charliemillhollinUST/TeensyDAQ_Hardware/README.md

The schematic and PCB were created in KiCad.

Contact <mill70882@stthomas.edu> for access to the TeensyDAQ repository.

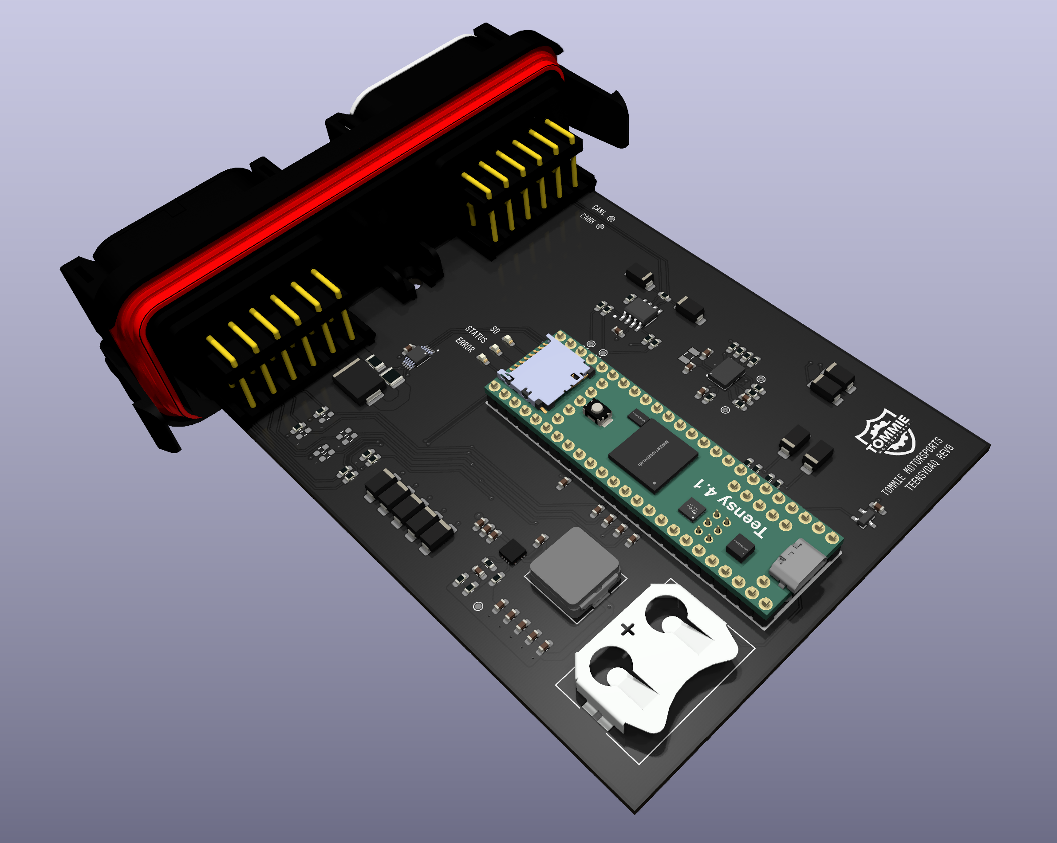
[picture p1: images/board_projection.png]
PCB
