charliemillhollinUST/TeensyDAQ_Hardware/images/board_bottom.png

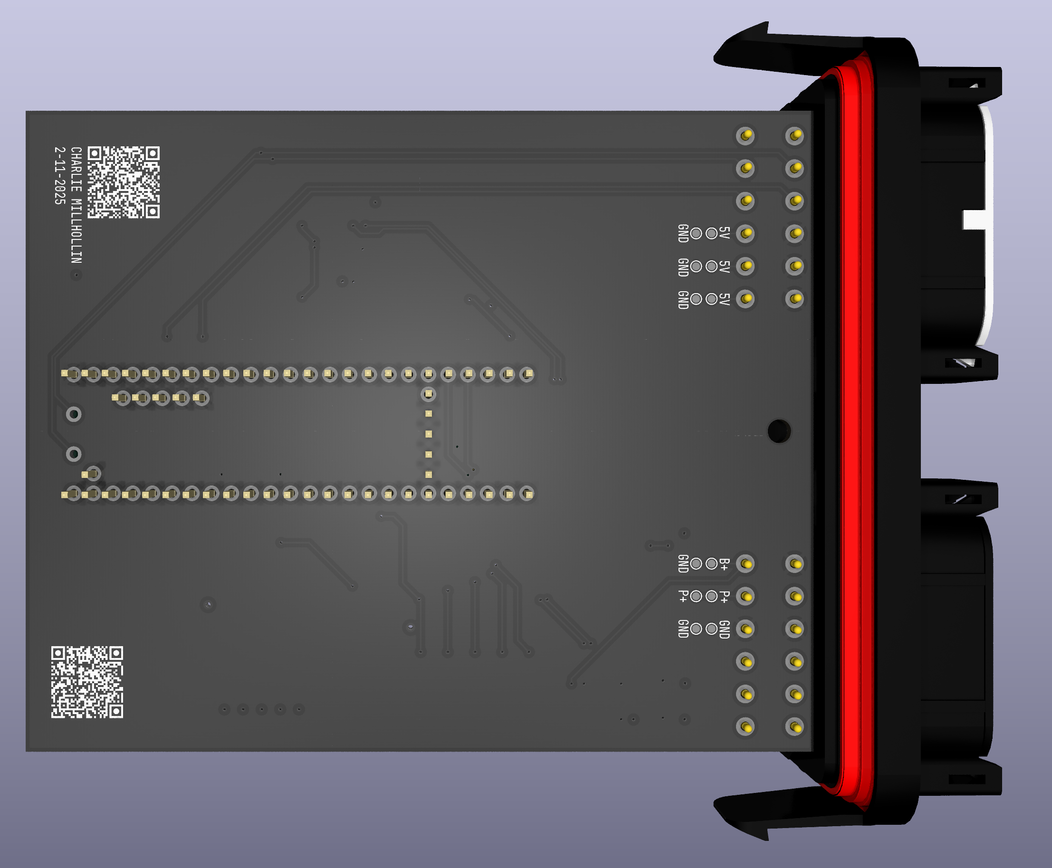
images/board_bottom.png
