charliemillhollinUST/TeensyDAQ_Hardware/images/board_top.png

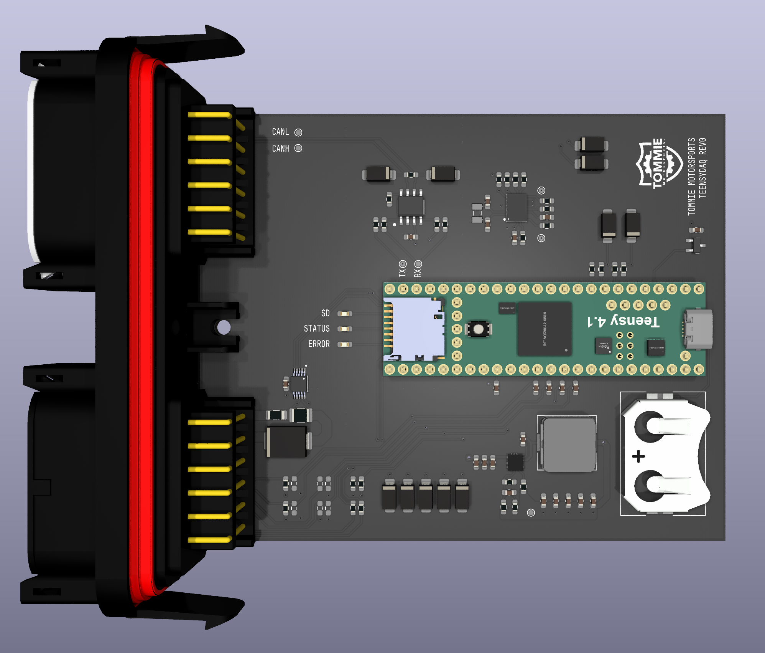
images/board_top.png
