charliemillhollinUST/TeensyDAQ_Hardware/TeensyDAQ_REV0.kicad_pcb

## KiCad design TeensyDAQ_REV0.kicad_pcb (2025-02-15)

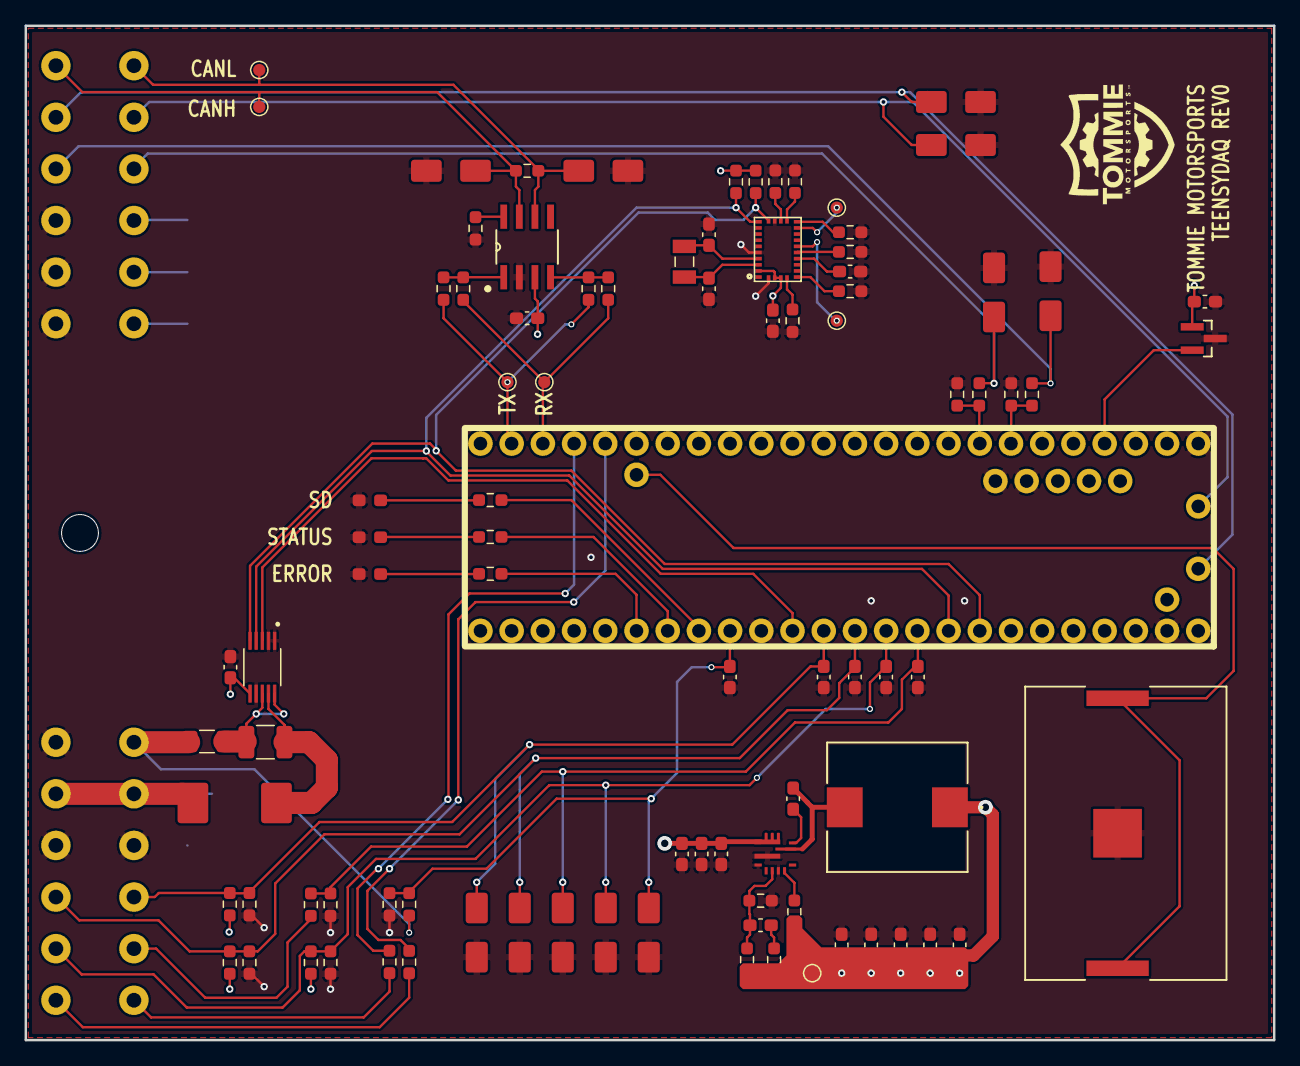
[picture p4: board TeensyDAQ_REV0.kicad_pcb from above]

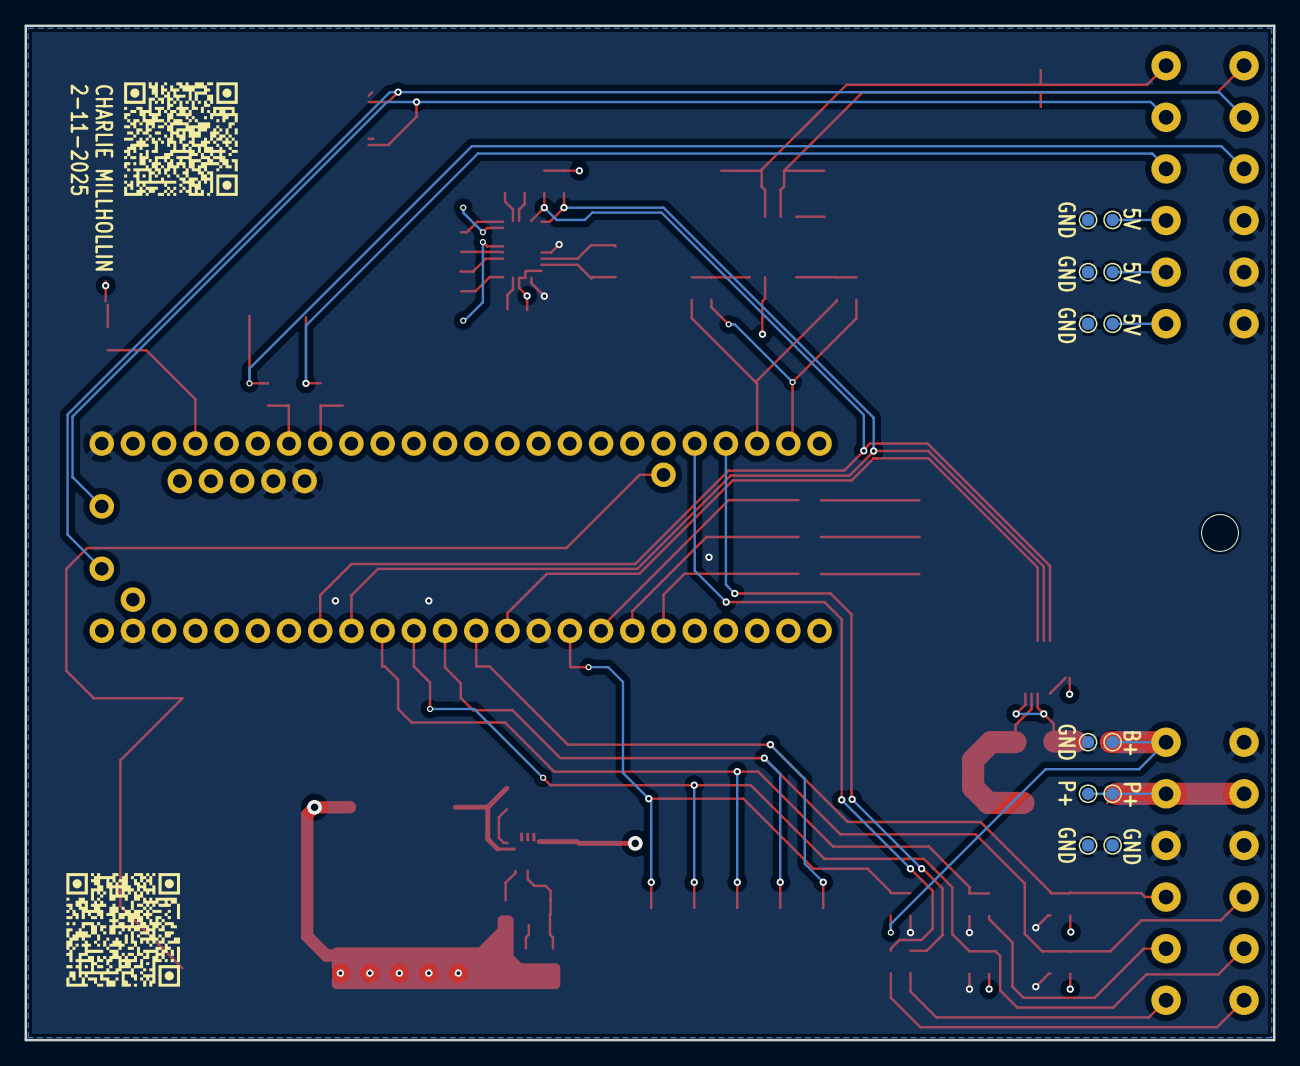
[picture p5: board TeensyDAQ_REV0.kicad_pcb from below]

Board: 4 copper layers, 101.6 x 82.6 mm, 105 parts (12 on the bottom side), 57 nets.

Parts:
5V, 5V103, 5V#2, 5V#3: TestPoint; TestPoint_Pad_D1.0mm
B100: 3034; 3034_KEY
B+: TestPoint; TestPoint_Pad_D1.0mm
C100, C101, C105, C106, C107, C108, C109: 10u; C_0603_1608Metric_Pad1.08x0.95mm_HandSolder
C102, C116, C117: 100n; C_0603_1608Metric_Pad1.08x0.95mm_HandSolder
C103, C110, C111, C112, C113, C114, C115, C120, C121: 0.1u; C_0603_1608Metric_Pad1.08x0.95mm_HandSolder
C104: 100p; C_0603_1608Metric_Pad1.08x0.95mm_HandSolder
C118, C119: 22p; C_0603_1608Metric_Pad1.08x0.95mm_HandSolder
CANH: TestPoint; TestPoint_Pad_D1.0mm
CANL: TestPoint; TestPoint_Pad_D1.0mm
D100, D101, D102: LED; LED_0603_1608Metric_Pad1.05x0.95mm_HandSolder
D103: B340; D_SMC
D104, D105, D106, D107, D108, D109, D110, D111, D112, D113, D115: SMAJ5.0A; D_SMA
F100: Fuse; Fuse_1206_3216Metric
GND: TestPoint; TestPoint_Pad_D1.0mm
GND#2, GND#3, GND#4, GND#5, GND#6: TestPoint; TestPoint_Pad_D1.0mm
J100: ATM13-12PA-12PB-BM01
L100: 3.3u; IND_IHLP-4040DZ_VIS
P+: TestPoint; TestPoint_Pad_D1.0mm
P+#2: TestPoint; TestPoint_Pad_D1.0mm
Q100: Teensy4_1
R100, R101, R102: 10; R_0603_1608Metric_Pad0.98x0.95mm_HandSolder
R103, R119, R121: 100k; R_0603_1608Metric_Pad0.98x0.95mm_HandSolder
R104: 20k; R_0603_1608Metric_Pad0.98x0.95mm_HandSolder
R105: 73.2k; R_0603_1608Metric_Pad0.98x0.95mm_HandSolder
R106, R113, R115, R117, R128, R129, R133, R134, R135: 10k; R_0603_1608Metric_Pad0.98x0.95mm_HandSolder
R107, R108, R109, R110, R111, R130, R131, R132, R140, R141: 0; R_0603_1608Metric_Pad0.98x0.95mm_HandSolder
R112: 120; R_0603_1608Metric_Pad0.98x0.95mm_HandSolder
R114, R116: 15k; R_0603_1608Metric_Pad0.98x0.95mm_HandSolder
R118: 3k; R_0603_1608Metric_Pad0.98x0.95mm_HandSolder
R120, R122, R123, R124, R125, R126: DNP; R_0603_1608Metric_Pad0.98x0.95mm_HandSolder
R127: 0.1; R_1210_3225Metric_Pad1.30x2.65mm_HandSolder
RX: TestPoint; TestPoint_Pad_D1.0mm
TP100, TP101: TestPoint; TestPoint_Pad_D1.0mm
TX: TestPoint; TestPoint_Pad_D1.0mm
U100: TPS56637RPAR; RPA0010A
U101: INA226AIDGSR
U102: BNO055; LGA28R50P4X10_380X520X100
U103: SN65HVD230DR; D8
U104: DRV5032FBDBZR; DBZ0003A-IPC_A
Y100: ABS07-32.768KHZ-T; XTAL_ABS07-32.768KHZ-T

Connections:
+3V3: C114.1, C116.2, C120.1, C121.1, Q100.-2 (3.3V), Q100.-5 (3.3V), R119.2, R121.2, R125.2, R128.2, R129.2, U101.6 (VS), U102.3 (VDD), U102.4 (NBOOT_LOAD_PIN), U102.28 (VDDIO), U103.3 (VCC), U104.1 (VCC)
+5V: 5V.1, 5V103.1, 5V#2.1, 5V#3.1, C105.2, C106.2, C107.2, C108.2, C109.2, J100.10 (Pin_10_1), J100.11 (Pin_11_1), J100.12 (Pin_12_1), L100.1, Q100.-3 (Vin), R103.2, R104.2, R105.2
/Analog/Battery_IN+: B+.1, F100.1, J100.13 (Pin_1_2), R117.2
/Analog/CVT_Thermistor+: C111.1, D110.1 (A1), J100.21 (Pin_9_2), Q100.15, R121.1, R122.2
/Analog/Engine_Thermistor+: C110.1, D113.1 (A1), J100.16 (Pin_4_2), Q100.14, R119.1, R120.2
/Analog/Hall_Signal1: D109.1 (A1), J100.4 (Pin_4_1), R113.2
/Analog/Hall_Signal1_u: Q100.5, R113.1, R114.2
/Analog/Hall_Signal2: D104.1 (A1), J100.9 (Pin_9_1), R115.2
/Analog/Hall_Signal2_u: Q100.6, R115.1, R116.2
/Analog/Magnet_u: Q100.2, U104.2 (OUT)
/Analog/Thermistor3_u: C113.1, D111.1 (A1), J100.20 (Pin_8_2), Q100.16, R125.1, R126.2
/Analog/VDIV1+: J100.17 (Pin_5_2), R123.2
/Analog/VDIV1_u: C112.1, D112.1 (A1), Q100.17, R123.1, R124.2
/Analog/VMeas_BATu: C115.1, D115.1 (A1), Q100.41, R117.1, R118.2
/CAN/CANH: CANH.1, D107.1 (A1), J100.6 (Pin_6_1), R112.2, U103.7 (CANH)
/CAN/CANL: CANL.1, D106.1 (A1), J100.7 (Pin_7_1), R112.1, U103.6 (CANL)
/CAN/CAN_RXu: Q100.30, R107.2, R108.2, RX.1
/CAN/CAN_TXu: Q100.31, R109.2, R110.2, TX.1
/Enclosure Connectors/P1: J100.18 (Pin_6_2), R141.1
/Enclosure Connectors/P2: J100.19 (Pin_7_2), R140.1
/Enclosure Connectors/Power_OUT+: C100.2, C101.2, C102.2, D103.1 (K), J100.14 (Pin_2_2), J100.23 (Pin_11_2), P+.1, P+#2.1, U100.8 (VIN)
/Enclosure Connectors/USB_D+: D105.1 (A1), J100.8 (Pin_8_1), Q100.-9 (D+_Device)
/Enclosure Connectors/USB_D-: D108.1 (A1), J100.5 (Pin_5_1), Q100.-8 (D-_Device)
/Gyro/I2C_SCL: Q100.19, R129.1, U101.5 (SCL), U102.19 (COM1)
/Gyro/I2C_SDA: Q100.18, R128.1, U101.4 (SDA), U102.20 (COM0)
/Power Biasing/INA226A_ALERT: Q100.13, U101.3 (ALERT)
CUR_S_+: F100.2, R127.1, U101.8 (VBUS), U101.10 (IN+)
CUR_S_-: D103.2 (A), R127.2, U101.9 (IN-)
ERROR_LED: Q100.38, R102.1
GND: B100.3, C100.1, C101.1, C102.1, C105.1, C106.1, C107.1, C108.1, C109.1, C110.2, C111.2, C112.2, C113.2, C114.2, C115.2, C116.1, C117.2, C118.2, C119.1, C120.2, C121.2, D100.1 (K), D101.1 (K), D102.1 (K), D104.2 (A2), D105.2 (A2), D106.2 (A2), D107.2 (A2), D108.2 (A2), D109.2 (A2), D110.2 (A2), D111.2 (A2), D112.2 (A2), D113.2 (A2), D115.2 (A2), GND.1, GND#2.1, GND#3.1, GND#4.1, GND#5.1, GND#6.1, J100.1 (Pin_1_1), J100.2 (Pin_2_1), J100.3 (Pin_3_1), J100.15 (Pin_3_2), J100.22 (Pin_10_2), J100.24 (Pin_12_2), Q100.-1 (GND), Q100.-4 (GND), Q100.-6 (GND), Q100.-13 (GND), Q100.-14 (GND), R106.1, R111.2, R114.1, R116.1, R118.1, R120.1, R122.1, R124.1, R126.1, R130.2, R131.2, R132.2, R133.2, R134.2, R135.2, U100.3 (AGND), U100.9 (PGND), U100.10 (MODE), U101.1 (A1), U101.2 (A0), U101.7 (GND), U102.2 (GND), U102.18 (COM2), U102.25 (GNDIO), U103.2 (GND), U104.3 (GND)
unnamed: C104.2, R104.1
unnamed: D100.2 (A), R102.2
unnamed: D101.2 (A), R101.2
unnamed: D102.2 (A), R100.2
unnamed: Q100.28, R140.2
unnamed: Q100.29, R141.2
unnamed: C103.2, U100.7 (BOOT)
unnamed: C104.1, R105.1, R106.2, U100.2 (FB)
unnamed: R103.1, U100.4 (PG)
unnamed: C103.1, L100.2, U100.6 (SW)
unnamed: C117.1, U102.9 (CAP)
unnamed: R133.1, U102.17 (COM3)
unnamed: TP101.1, U102.14 (INT)
unnamed: TP100.1, U102.11 (NRESET)
unnamed: R130.1, U102.10 (PIN10)
unnamed: R131.1, U102.15 (PIN15)
unnamed: R132.1, U102.16 (PIN16)
unnamed: R134.1, U102.6 (PS0)
unnamed: R135.1, U102.5 (PS1)
unnamed: R107.1, R109.1, U103.1 (D)
unnamed: R108.1, R110.1, U103.4 (R)
unnamed: R111.1, U103.8 (RS)
RTC_BAT+: B100.1, B100.2, Q100.-19 (VBAT)
SD_LED: Q100.40, R101.1
XIN32: C118.1, U102.27 (XIN32), Y100.1
XOUT32: C119.2, U102.26 (XOUT32), Y100.2
uLED: Q100.39, R100.1
