charliemillhollinUST/TeensyDAQ_Hardware/(commit log)

2025-01-23 cleaned up routing on main page of schematic
    [TeensyDAQ_REV0.kicad_sch]
2025-01-25 test commit
    [Teensy.kicad_sch]
2025-02-11 Added gyro, current sense, removed servo control, added temp sense
    [ATM13-12PA-12PB-BM01.kicad_sch, Analog.kicad_sch, CAN.kicad_sch, Power_Biasing.kicad_sch, Teensy.kicad_sch, TeensyDAQ_REV0.kicad_pcb, TeensyDAQ_REV0.kicad_sch, gyro.kicad_sch]
2025-02-11 finished up schematic, added magnetic sensor, cleaned up pins, etc.
    [ATM13-12PA-12PB-BM01.kicad_sch, Analog.kicad_sch, CAN.kicad_sch, Power_Biasing.kicad_sch, Teensy.kicad_sch, TeensyDAQ_REV0.kicad_pcb, TeensyDAQ_REV0.kicad_sch, gyro.kicad_sch]
2025-02-11 cleaned up refdes
    [CAN.kicad_sch, TeensyDAQ_REV0.kicad_pcb]
2025-02-11 final route. Needs revision and check of via placement.
    [ATM13-12PA-12PB-BM01.kicad_sch, Teensy.kicad_sch, TeensyDAQ_REV0.kicad_pcb]
2025-02-11 added ground planes and 4 layer. Ran DRC and checked out
    [TeensyDAQ_REV0.kicad_pcb, bom.csv, designators.csv, positions.csv]
2025-02-11 ran fabrication output to get basic quote. Need to run iBOM and add digikey links
    [bom.csv, designators.csv]
2025-02-11 added more power tracks to power layer. re-ran fabrication output
    [TeensyDAQ_REV0.kicad_pcb]
2025-02-11 removed a VDIV input and changed it to a thermistor input. Re-ran fabrication output
    [ATM13-12PA-12PB-BM01.kicad_sch, Analog.kicad_sch, CAN.kicad_sch, Teensy.kicad_sch, TeensyDAQ_REV0.kicad_pcb, TeensyDAQ_REV0.kicad_sch, bom.csv, designators.csv]
2025-02-11 added 5V test point at caps
    [Power_Biasing.kicad_sch, TeensyDAQ_REV0.kicad_pcb, bom.csv, designators.csv]
2025-02-11 added GND vias to copper pour next to i2c lines to hopefully reduce noise
    [TeensyDAQ_REV0.kicad_pcb]
2025-02-11 changed date lol
    [TeensyDAQ_REV0.kicad_pcb]
2025-02-12 added TVS diodes to external pins for protection. Ran fabrication output. Ran iBOM generation. All part links can be seen in the iBOM. Download and open to see this
    [ATM13-12PA-12PB-BM01.kicad_sch, Analog.kicad_sch, CAN.kicad_sch, Power_Biasing.kicad_sch, Teensy.kicad_sch, TeensyDAQ_REV0.kicad_pcb, TeensyDAQ_REV0.kicad_sch, bom.csv]
2025-02-12 file cleanup
    [Differential_Control.kicad_sch]
2025-02-12 updated QR code to match github repository on silkscreen
    [TeensyDAQ_REV0.kicad_pcb, designators.csv]
2025-02-12 added power planes to correct layer. Added 10A 1206 fuse to battery input before current measurement resistor and reverse polarity diode
    [Power_Biasing.kicad_sch, TeensyDAQ_REV0.kicad_pcb, bom.csv, designators.csv, positions.csv]
2025-02-12 updated QR code
    [TeensyDAQ_REV0.kicad_pcb]
2025-02-12 updated silkscreen
    [TeensyDAQ_REV0.kicad_pcb]
2025-02-12 updated power traces. Updated silkscreen
    [TeensyDAQ_REV0.kicad_pcb]
2025-02-14 commit for sanity
    [TeensyDAQ_REV0.kicad_pcb, positions.csv]
2025-02-14 larger silkscreen
    [TeensyDAQ_REV0.kicad_pcb, positions.csv]
2025-02-14 corrected template directory. From FDC103-01
    [ATM13-12PA-12PB-BM01.kicad_sch, Analog.kicad_sch, CAN.kicad_sch, Power_Biasing.kicad_sch, Teensy.kicad_sch, TeensyDAQ_REV0.kicad_pcb, gyro.kicad_sch]
2025-02-14 working through adding LED indicator silkscreen. Had to leave because Luke sprayed oil everywhere
    [TeensyDAQ_REV0.kicad_pcb]
2025-02-15 updated silkscreen. Re-ran fab toolkit and iBOM. Looking to order today
    [TeensyDAQ_REV0.kicad_pcb]
2025-02-15 added gnd via to clean up copper pour
    [TeensyDAQ_REV0.kicad_pcb]
